true-nature/App_BicycleFinder/README.md

App_BicycleFinder
=================

Bicycle finder in parking area.
It works on TOCOS TWE-Lite.
You can find your bicycle by melody controlled by wireless remote commander.
