true-nature/App_BicycleFinder/Circuits/Receiver/FinderReceiver.kicad_pcb

## KiCad design Circuits/Receiver/FinderReceiver.kicad_pcb (2016-04-13)

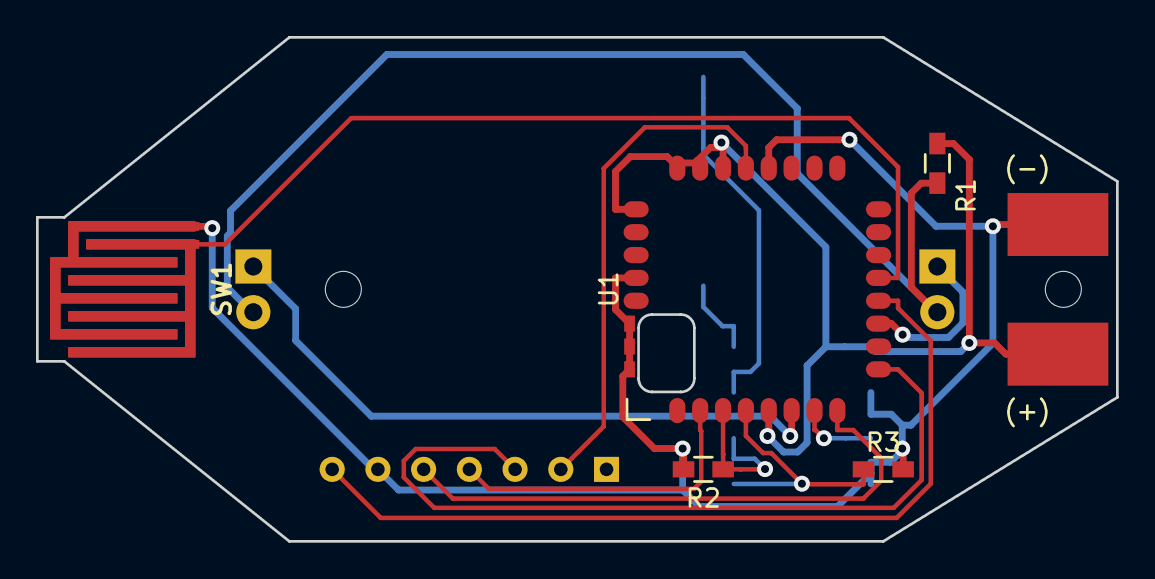
[picture p1: board FinderReceiver.kicad_pcb from above]

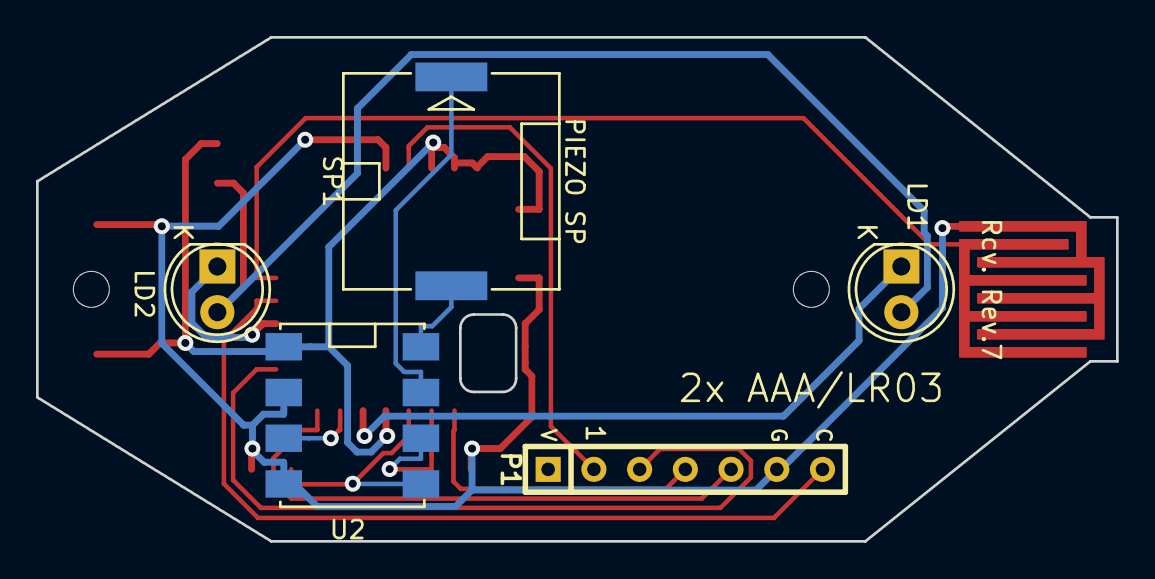
[picture p2: board FinderReceiver.kicad_pcb from below]

Board: 2 copper layers, 60.0 x 28.0 mm, 11 parts (6 on the bottom side), 16 nets.

Parts:
BT1: 2x AAA/LR03; FINDER_RECEIVER
LD1, LD2: LED; LED-5MM
P1: WRITER-VCC; WRITE-7P
R1: 680; R_0603_HandSoldering
R2, R3: 2M; R_0603_HandSoldering
SP1: PIEZO SP; PIEZOSPK
SW1: SW_PUSH; RUBBER_SWITCH
U1: TWE_LITE_SMD; TWE-001L-NC7
U2: NJU72501MJE; AE-NJU72501MJE

Connections:
/CFG: P1.6, U1.12
/DI1: SW1.1, U1.13
/DO3: LD1.1, U1.6
/DO4: LD2.1, U1.11
/EN1: R2.1, U1.3, U2.6
/EN2: R3.1, U1.4, U2.5
/LED: LD1.2, LD2.2, R1.2
/PRG: P1.3, U1.2
/RST: P1.1, U1.21
/RXD: P1.2, U1.9
/SOUND: U1.7, U2.3
/TXD: P1.4, U1.8
/VO1: SP1.1, U2.8
/VO2: SP1.2, U2.7
GND: BT1.2, P1.5, R2.2, R3.2, SW1.2, U1.20, U1.28, U1.30, U1.31, U1.32, U2.2, U2.4
VCC: BT1.1, R1.1, U1.5, U1.22, U1.23, U1.24, U1.25, U2.1
