true-nature/App_BicycleFinder/Circuits/SmallSender/SmallSender.kicad_pcb

## KiCad design Circuits/SmallSender/SmallSender.kicad_pcb (2016-03-06)

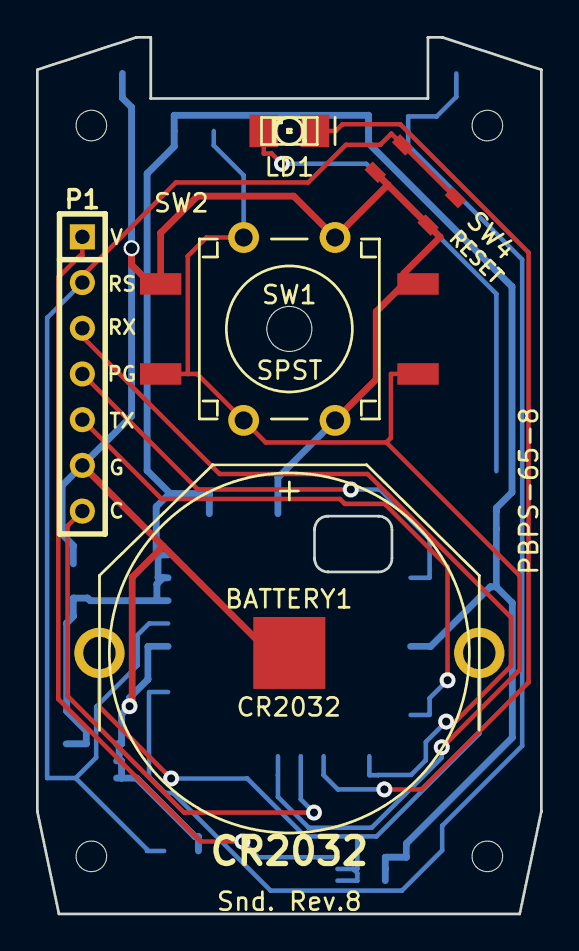
[picture p3: board SmallSender.kicad_pcb from above]

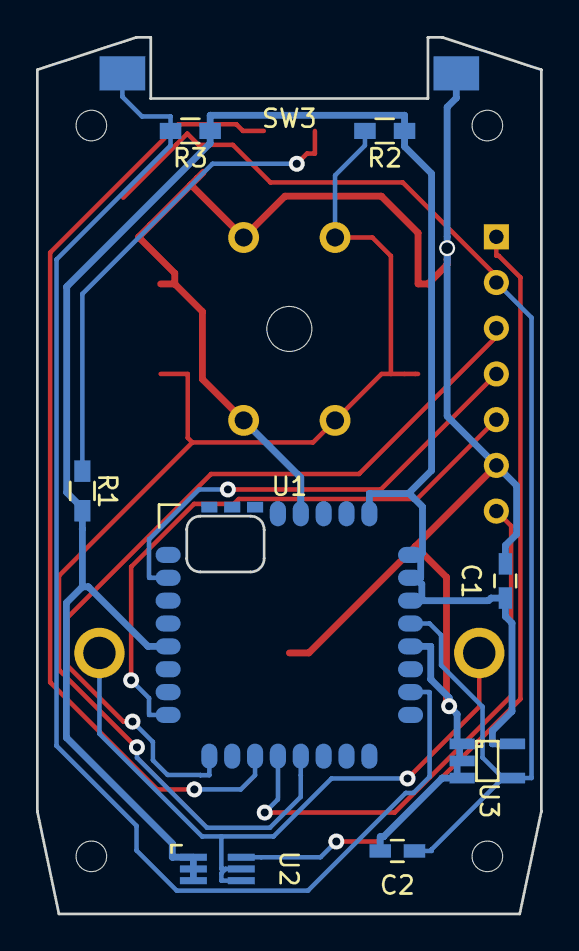
[picture p4: board SmallSender.kicad_pcb from below]

Board: 2 copper layers, 28.0 x 48.7 mm, 16 parts (9 on the bottom side), 13 nets.

Parts:
BATTERY1: CR2032; BK-888
C1: 10u; C_0603_HandSoldering
C2: 1000p; C_0603_HandSoldering
LD1: SML-012WT; LED-1206
P1: WRITER-VCC; WRITE-7P
PBPS-65-8: Snd. Rev.8; PBPS-65
R1: 680; R_0603_HandSoldering
R2, R3: 1M; R_0603_HandSoldering
SW1: SPST; B3FS-4002P_centerHole2_5mm
SW2: SPST; JB-15HFBP2
SW3: FR2S1015
SW4: SKRPACE010
U1: TWE_LITE_SMD; TWE-001L-NC7
U2: HN2S01FU; SC-70-6_Handsoldering
U3: BD45231G; SSOP5_Handsoldering

Connections:
/3V: BATTERY1.1, U2.4, U2.5
/CFG: P1.6, U1.12
/DI1: R2.2, SW1.1, SW2.1, U1.13
/DI4: R3.2, SW3.1, U1.18
/DO4: LD1.1, U1.11
/ExtVcc: P1.0, U2.6
/LED: LD1.2, R1.2
/PRG: P1.3, U1.2
/RST: C2.1, P1.1, SW4.1, U1.21, U3.4
/RXD: P1.2, U1.9
/TXD: P1.4, U1.8
/Vcc: C1.1, R1.1, R2.1, R3.1, U1.5, U1.22, U1.23, U1.24, U1.25, U2.1, U2.2, U2.3, U3.5
GND: BATTERY1.2, C1.2, C2.2, P1.5, SW1.2, SW2.2, SW3.2, SW4.2, U1.20, U1.28, U3.1, U3.2, U3.3
