true-nature/App_BicycleFinder/Common/Source/appsave.h

/****************************************************************************
 * (C) Tokyo Cosmos Electric, Inc. (TOCOS) - all rights reserved.
 *
 * Condition to use: (refer to detailed conditions in Japanese)
 *   - The full or part of source code is limited to use for TWE (TOCOS
 *     Wireless Engine) as compiled and flash programmed.
 *   - The full or part of source code is prohibited to distribute without
 *     permission from TOCOS.
 *
 * 利用条件:
 *   - 本ソースコードは、別途ソースコードライセンス記述が無い限り東京コスモス電機が著作権を
 *     保有しています。
 *   - 本ソースコードは、無保証・無サポートです。本ソースコードや生成物を用いたいかなる損害
 *     についても東京コスモス電機は保証致しません。不具合等の報告は歓迎いたします。
 *   - 本ソースコードは、東京コスモス電機が販売する TWE シリーズ上で実行する前提で公開
 *     しています。他のマイコン等への移植・流用は一部であっても出来ません。
 *
 ****************************************************************************/

#ifndef APPSAVE_H_
#define APPSAVE_H_

#include <jendefs.h>

/** @ingroup FLASH
 * フラッシュ格納データ構造体
 */
typedef struct _tsFlashApp {
	uint32 u32appkey;		//!<
	uint32 u32ver;			//!<

	uint32 u32appid;		//!< アプリケーションID
	uint32 u32chmask;		//!< 使用チャネルマスク（３つまで）
	uint8 u8id;				//!< 論理ＩＤ (子機 1～100まで指定)
	uint8 u8ch;				//!< チャネル（未使用、チャネルマスクに指定したチャネルから選ばれる）
	uint8 u8pow;			//!< 出力パワー (0-3)
	uint8 u8role;			//!< 未使用(将来のための拡張)
	uint8 u8layer;			//!< 未使用(将来のための拡張)

	uint16 u16SleepDur_ms;	//!< mode4 スリープ期間[ms]
	uint16 u16SleepDur_s; 	//!< mode7 スリープ期間[s]
	uint8 u8Fps;			//!< mode3 毎秒送信回数 (4,8,16,32)

	uint32 u32baud_safe;	//!< ボーレート
	uint8 u8parity;         //!< パリティ 0:none, 1:odd, 2:even

	uint32 u32PWM_Hz;		//!< PWM変更設定周期

	uint32 u32Opt;			//!< 色々オプション
	uint32 u32Opt2;		//!< プルアップ設定 bit0:3->DI1-4, bit4-8:DO5-7

	uint8 u8MML_idx;		//!< MML選曲インデックス
} tsFlashApp;


#endif /* APPSAVE_H_ */
