true-nature/App_BicycleFinder/Master/Source/Experimental.h

/****************************************************************************
 * (C) Tokyo Cosmos Electric, Inc. (TOCOS) - 2013 all rights reserved.
 *
 * Condition to use: (refer to detailed conditions in Japanese)
 *   - The full or part of source code is limited to use for TWE (TOCOS
 *     Wireless Engine) as compiled and flash programmed.
 *   - The full or part of source code is prohibited to distribute without
 *     permission from TOCOS.
 *
 * 利用条件:
 *   - 本ソースコードは、別途ソースコードライセンス記述が無い限り東京コスモス電機が著作権を
 *     保有しています。
 *   - 本ソースコードは、無保証・無サポートです。本ソースコードや生成物を用いたいかなる損害
 *     についても東京コスモス電機は保証致しません。不具合等の報告は歓迎いたします。
 *   - 本ソースコードは、東京コスモス電機が販売する TWE シリーズ上で実行する前提で公開
 *     しています。他のマイコン等への移植・流用は一部であっても出来ません。
 *
 ****************************************************************************/

#ifndef EXPERIMENTAL_H_
#define EXPERIMENTAL_H_

/****************************************************************************/
/***        実験的な実装定義                                              ***/
/****************************************************************************/

/** @ingroup MASTER
 * I2C LCD モジュールテスト用のコード
 *   本定義が実装されると、I2C 接続の LCD デバイスにテスト文字を表示する
 *   - IO入力を受け取った時そのボタンに応じたメッセージを表示
 *   - インタラクティブモードで 1-4 に対応してメッセージを表示
 */
#undef USE_I2C_LCD_TEST_CODE
#ifdef USE_I2C_LCD_TEST_CODE
#warning "EXPERIMENTAL: USE_I2C_LCD_TEST_CODE"
const char astrLcdMsgs[4][2][16] = {
	{	"TEST1 67812345678", "ABCDefghIJKLmnop"},
	{	"TEST2 67812345678", "ABCDefghIJKLmnop"},
	{	"TEST3 67812345678", "ABCDefghIJKLmnop"},
	{	"TEST4 67812345678", "ABCDefghIJKLmnop"},
};
#endif

/** @ingroup MASTER
 * Sleep 中に IO の出力状態を設定する
 *   DO0,1を Sleep 中は Hi, 稼働中は Lo
 */
#undef SET_DO_ON_SLEEP
#ifdef SET_DO_ON_SLEEP
#warning "EXPERIMENTAL: SET_DO_ON_SLEEP"
static uint8 u8SleepControl = 0; //!< 0:事前Sleep, 1:通常
#define PRE_SLEEP_ms 50
#endif

/** @ingroup MASTER
 * BROWNOUT 検出時にリセットする。
 */
#undef USE_BROWN_OUT_DETECT
#ifdef USE_BROWN_OUT_DETECT
# warning "#define USE_BROWN_OUT_DETECT"
#endif

/** @ingroup MASTER
 * 電源投入時に一定時間ポートをONにする
 */
#undef USE_INITIAL_PORT_ON //!< 起動時にポートをONにする
#ifdef USE_INITIAL_PORT_ON
# warning "#define USE_INITIAL_PORT_ON"
#endif

/** @ingroup MASTER
 * I2Cポートを入力として利用し、かつチャネル切り替えに使用する
 *
 * 両方のピンが HI の場合は、インタラクティブモードの設定となり、
 * それ以外の場合は、以下に定義している CHMASK_1-3 に切り替わる。
 */
#undef USE_I2C_PORT_AS_CHANNEL_SET
#ifdef USE_I2C_PORT_AS_CHANNEL_SET
#define USE_I2C_PORT_AS_OTHER_FUNCTION
#warning "EXPERIMENTAL: USE_I2C_PORT_AS_CHANNEL_SET"

#define CHANNEL_1 12
#define CHMASK_1 (1UL << CHANNEL_1) //!< チャネルマスク（３つまで指定する事が出来る）
#define CHANNEL_2 21
#define CHMASK_2 (1UL << CHANNEL_2) //!< チャネルマスク（３つまで指定する事が出来る）
#define CHANNEL_3 24
#define CHMASK_3 (1UL << CHANNEL_3) //!< チャネルマスク（３つまで指定する事が出来る）

// チャネルのテーブル
const uint32 au32ChMask_Preset[] = { 0UL, CHMASK_1, CHMASK_2, CHMASK_3, };

// ピンの選択 (0-3)
static uint8 u8ChPreSet = 0;

static void vChangeChannelPreset(uint8 u8preset);
#endif

/** @ingroup MASTER
 * I2Cポートを入力として利用し、かつ PWM の特殊制御に使用する
 * (USE_I2C_PORT_AS_CHANNEL_SET と両方定義すると、チャネル切り替えと
 *  PWM 制御パターンを同時に切り替える)
 *
 * 両ポートがHIの場合は、PWMのデューティ比設定
 * 他の設定は、サイン、脈動、パルス
 *
 * ※ PWM の出力を反転したい場合は、cbToCoNet_u8HwInt() 中の PWM 設定部で
 *    u16duty 値を反転させるとよいだろう。
 *
 *    sTimerPWM[i].u16duty = 1024 - sTimerPWM[i].u16duty; // 値を反転
 *    vTimerStart(&sTimerPWM[i]);
 */
#undef USE_I2C_PORT_AS_PWM_SPECIAL

#if defined(USE_I2C_PORT_AS_PWM_SPECIAL)
#define USE_I2C_PORT_AS_OTHER_FUNCTION
#warning "EXPERIMENTAL: USE_I2C_PORT_AS_OTHER_FUNCTION"
uint8 u8PwmSpe_TxMode = 0;
uint8 u8PwmSpe_RxMode = 0;

// タイマー管理のためのカウンター
struct {
	uint16 u16Ct_Active[4]; // Active 期間のカウンタ数 (このときだけ光る）
	uint16 u16Ct_Total[4]; // トータルカウンタ数
	uint16 u16Ct_Now[4]; // 現在のカウント値 (100でループする)
} sPwmSpe_Context;

// サイン波のテーブル
const uint16 u16PwmSpe_SinTbl[101] = { 0, 32, 64, 96, 128, 160, 192, 223, 255,
		286, 316, 347, 377, 407, 436, 465, 493, 521, 549, 576, 602, 628, 653,
		677, 701, 724, 746, 768, 789, 809, 828, 847, 865, 881, 897, 912, 927,
		940, 952, 963, 974, 983, 992, 999, 1006, 1011, 1016, 1019, 1022, 1023,
		1024, 1023, 1022, 1019, 1016, 1011, 1006, 999, 992, 983, 974, 963, 952,
		940, 927, 912, 897, 881, 865, 847, 828, 809, 789, 768, 746, 724, 701,
		677, 653, 628, 602, 576, 549, 521, 493, 465, 436, 407, 377, 347, 316,
		286, 255, 223, 192, 160, 128, 96, 64, 32, 0 };

// ふわっとするテーブル
const uint16 u16PwmSpe_fuwa[101] = { 0, 0, 2, 4, 7, 10, 15, 20, 26, 33, 41, 50,
		59, 69, 80, 92, 105, 118, 133, 148, 164, 181, 198, 217, 236, 256, 277,
		299, 321, 344, 369, 394, 419, 446, 473, 502, 531, 561, 591, 623, 655,
		689, 723, 757, 793, 829, 867, 905, 944, 983, 1024, 1024, 1024, 1024,
		1024, 1024, 1024, 1024, 1024, 1024, 960, 896, 832, 768, 704, 640, 576,
		512, 448, 384, 320, 256, 192, 128, 64, 0, 0, 0, 0, 0, 0, 0, 0, 0, 0, 0,
		0, 0, 0, 0, 0, 0, 0, 0, 0, 0, 0, 0, 0, 0, 0 };

// 可変抵抗の C カーブから B カーブへの変換（意味あるかな？）
const uint16 au16_CtoBcurve[1025] = { 0, 4, 8, 12, 16, 20, 24, 28, 32, 36, 40,
		44, 47, 51, 55, 58, 62, 66, 69, 73, 76, 80, 83, 87, 90, 93, 97, 100,
		103, 106, 110, 113, 116, 119, 122, 126, 129, 132, 135, 138, 141, 144,
		147, 150, 153, 156, 158, 161, 164, 167, 170, 173, 175, 178, 181, 184,
		186, 189, 192, 194, 197, 200, 202, 205, 207, 210, 212, 215, 217, 220,
		222, 225, 227, 230, 232, 235, 237, 239, 242, 244, 247, 249, 251, 254,
		256, 258, 260, 263, 265, 267, 269, 272, 274, 276, 278, 280, 282, 285,
		287, 289, 291, 293, 295, 297, 299, 301, 303, 305, 308, 310, 312, 314,
		316, 318, 320, 321, 323, 325, 327, 329, 331, 333, 335, 337, 339, 341,
		343, 344, 346, 348, 350, 352, 354, 355, 357, 359, 361, 363, 364, 366,
		368, 370, 371, 373, 375, 377, 378, 380, 382, 384, 385, 387, 389, 390,
		392, 394, 395, 397, 399, 400, 402, 403, 405, 407, 408, 410, 411, 413,
		415, 416, 418, 419, 421, 422, 424, 426, 427, 429, 430, 432, 433, 435,
		436, 438, 439, 441, 442, 444, 445, 447, 448, 450, 451, 452, 454, 455,
		457, 458, 460, 461, 462, 464, 465, 467, 468, 469, 471, 472, 474, 475,
		476, 478, 479, 480, 482, 483, 484, 486, 487, 488, 490, 491, 492, 494,
		495, 496, 498, 499, 500, 502, 503, 504, 505, 507, 508, 509, 510, 512,
		513, 514, 515, 517, 518, 519, 520, 522, 523, 524, 525, 527, 528, 529,
		530, 531, 533, 534, 535, 536, 537, 539, 540, 541, 542, 543, 544, 546,
		547, 548, 549, 550, 551, 552, 554, 555, 556, 557, 558, 559, 560, 562,
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
		365, 366, 367, 368, 369, 370, 371, 372, 373, 374, 375, 376, 377, 378,
		379, 380, 381, 382, 383, 384, 385, 386, 387, 388, 389, 390, 391, 392,
		393, 394, 395, 396, 397, 398, 399, 400, 401, 402, 404, 405, 406, 407,
		408, 409, 410, 411, 412, 413, 414, 415, 416, 417, 418, 419, 420, 422,
		423, 424, 425, 426, 427, 428, 429, 430, 431, 432, 433, 435, 436, 437,
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

#endif

/** @ingroup MASTER
 * AI4 の変わりに電源電圧を読み出して送信する。
 *
 * 2.5V 以上 (PWM=0%) 2.5V 以下 (PWM=50%), 2.3V以下 (PWM=100%)
 */
#undef USE_PWM4_AS_BAT_MONITOR
#ifdef USE_PWM4_AS_BAT_MONITOR
#warning "EXPERIMENTAL: USE_PWM4_AS_BAT_MONITOR"
#endif

/** @ingroup MASTER
 * 間欠モード時にゆっくり送信する
 */
#undef USE_SLOW_TX
#ifdef USE_SLOW_TX
#warning "EXPERIMENTAL: USE_SLOW_TX"
#endif
#endif /* EXPERIMENTAL_H_ */
