true-nature/App_BicycleFinder/(commit log)

2014-09-09 App_TweLite 1.7から派生。
2014-09-10 スリープ抑止を開放するため、再生終了時にbHoldPlayをFALSEに変える。
2014-09-10 シリアル番号をベースにした独自のAPP_IDへ変更。
2014-09-10 1秒スリープでの受信処理を有効化。 メロディ再生中はスリープを抑止。
2014-09-10 改造部分を ENABLE_RX_ON_SLP_1SEC で切り分けた。
2014-09-10 リリースノートを独自内容に変更。
2014-09-10 再生の終了待ちを独立した状態に分離。
2014-09-10 再生待ちを行うユーザー定義状態を新設。 再生の最大時間を60秒に制限。
2014-09-13 3曲目のメロディをHappy Birthdayに変更。
2014-09-13 間欠受信に失敗。
2014-09-13 他のdefineにあわせてUSE_RX_ON_SLP_1SECにrename。
2014-09-13 誤って除隊したSILENT_MODEの受信処理スキップを元に戻した。
2014-09-13 Revert "誤って除隊したSILENT_MODEの受信処理スキップを元に戻した。"
    This reverts commit 6c30a227d46dbb01fb6ffa2821d9764f91923357.
    [Master.c]
2014-09-13 SILENT_MODEと誤認して戻した変更を戻した。
2014-09-14 再生中で無い場合にLEDが一瞬点滅する場合があるバグを修正。
2014-09-14 バッテリー電圧が低下したときに点滅周期を短くする機能を追加。
2014-09-16 連続モードでもLEDを点滅させるようにした。
2014-09-17 状態遷移のタイミングをUARTに出力
2014-09-18 ADC無効化オプションが指定された場合、電源電圧だけをADC対象とする。 子機間欠モードでADC実行間隔を延長できるようにした。
2014-09-18 ADCスキップ時に受信時間を確保する。
2014-09-18 受信待ちを独立した状態で確保。
2014-09-18 連続送信を毎秒64回に増やしてWakeUp時間を減らした。
2014-09-22 再生終了時は無条件に割り込み時の再生処理を無効とする。
2014-09-22 リモコン側を子機間欠10秒モードで使用。
2014-09-23 mode4の通信間隔デフォルト値を4秒に延長。
2014-09-23 改造結果をリリースノートに反映。
2014-09-23 Bsch3vで描いた回路図を追加。
2014-09-24 SMD(QFN)版回路図を追加。
2014-09-24 QFN版DO4,GND配線ミスを修正。
2014-09-24 RESET SWを記入。
2014-09-25 未使用の宣言を削除。
2014-09-25 誤ったstatic修飾を削除。
2014-10-01 Moved circuit diagram to subdirectory.
2014-10-14 子機から子機への通信を、宛先IDによって有効とする。
2014-12-15 Change operation mode to 3,4 or 7 by Device Id.
2014-12-15 Removed pull-up of analog input. Added program writer connector.
2014-12-15 Added SMD version of sender circuit.
2014-12-16 コマンド0x95,0x96でMMLデータのread/writeを定義。
2014-12-18 Reduced wires.
2014-12-18 Fixed: EEPROM were overwritten.
    [melody_defs.c]
2014-12-19 Created KiCAD project file.
    [BicycleFinder.sch]
2014-12-19 User more LEDs.
2014-12-20 Inverted octave up/down characters.
    [melody_defs.c, mml.c]
2014-12-20 Blink LED3, like LED4.
2014-12-20 子機間欠モードでチャンネル指定が有効になるようにした。
2014-12-22 Fixed: MML data was shorten before save.
    [melody_defs.c]
2014-12-22 Continuous transmission is allowed if battery level is sufficient.
2014-12-22 Replaced voltage values to macro.
    [Master.c]
2014-12-22 bWakeupByButton is not reliable. Determine to repeat or not by EDLC voltage.
2014-12-24 Updated KiCAD data.
    [BicycleFinder.sch]
2014-12-25 ERC passed.
    [BicycleFinder.kicad_pcb, BicycleFinder.sch]
2014-12-25 Added parentheses. Static analysis says that it may be a bug.
    [Master.c]
2014-12-30 Made an example layout.
    [BicycleFinder.kicad_pcb, BicycleFinder.sch]
2015-01-04 CS75サイズ検討中。
    [BicycleFinder.kicad_pcb]
2015-01-06 Inserted a register to reduce discharge current from CR2032.
2015-01-07 Trying layout on TAKACHI PS-85.
    [BicycleFinder.kicad_pcb, BicycleFinder.sch]
2015-01-07 Removed old route.
    [BicycleFinder.kicad_pcb]
2015-01-07 Added monitor LED.
    [BicycleFinder.kicad_pcb, BicycleFinder.sch]
2015-01-08 Moved PS-85 shape to Edge layer.
    [BicycleFinder.kicad_pcb]
2015-01-08 Added an antenna shape in F.Silk layer.
    [BicycleFinder.kicad_pcb, BicycleFinder.sch]
2015-01-08 Added 3D data of 1F EDLC designed by FreeCAD.
    [SE-5R5-D105VY.FCStd]
2015-01-09 Created a 3D shape of EDLC.
    [BicycleFinder.kicad_pcb]
2015-01-09 Added FreeCAD 3D model of TWE-001L-SMD.
    [TWE-001L-SMD.FCStd]
2015-01-09 Add 3D data of TWE-001L-SMD to KiCAD module.
    [BicycleFinder.kicad_pcb, TWE-001L-SMD.FCStd]
2015-01-10 Updated 3D model of 1F EDLC.
    [BicycleFinder.kicad_pcb, SE-5R5-D105VY.FCStd]
2015-01-10 Added 3D model of tactical switch.
    [BicycleFinder.kicad_pcb, JF-15CKCBNP2.FCStd]
2015-01-11 Colored 1F EDLC.
    [BicycleFinder.kicad_pcb, BicycleFinder.sch, SE-5R5-D105VY.FCStd, TWE-001L-SMD.FCStd]
2015-01-12 Added 3D model of BK-888, BK-2032M, CR2032.
    [BicycleFinder.kicad_pcb]
2015-01-12 Marked plus sign on BK-888 3D model.
    [BK-888.FCStd, BicycleFinder.kicad_pcb]
2015-01-12 Swapped location of bigger parts.
    [BicycleFinder.kicad_pcb, JF-15CKCBNP2.FCStd]
2015-01-12 Moved P1 to keep distance from NTH.
    [BicycleFinder.kicad_pcb]
2015-01-14 Fixed: Miss-connected GND line.
    [BicycleFinder.kicad_pcb, BicycleFinder.sch]
2015-01-14 Don't use arc in Edge.Cut layer.
    [BicycleFinder.kicad_pcb]
2015-01-14 Added a diode array.
    [BicycleFinder.kicad_pcb, BicycleFinder.sch, HN2S01FU.FCStd]
2015-01-16 Replaced BK-888 to SMTU2032.
    [BK-888.FCStd, BicycleFinder.kicad_pcb, BicycleFinder.sch, SMTU2032.FCStd]
2015-01-16 Added 3D model of PS-85.
    [PS-85.FCStd]
2015-01-18 Replaced EDLC. Moved origin of TWE-001L.
    [BicycleFinder.kicad_pcb, BicycleFinder.sch, SE-5R5-D105VYV.FCStd, TWE-001L-SMD.FCStd]
2015-01-18 Added indicator LED.
2015-01-20 Copied models from DoorChecker.
    [BicycleFinder.kicad_pcb, BicycleFinder.sch]
2015-01-21 Moved BSch3V data to subdirectory.
    [BK-888.FCStd, BicycleFinder.kicad_pcb, BicycleFinder.sch, HN2S01FU.FCStd, JF-15CKCBNP2.FCStd, PS-85.FCStd, SE-5R5-D105VY.FCStd, SE-5R5-D105VYV.FCStd]
2015-01-21 Moved libraries to ../kicad-twe.
    [BK-888.FCStd, HN2S01FU.FCStd, JF-15CKCBNP2.FCStd, PS-85.FCStd, SE-5R5-D105VY.FCStd, SE-5R5-D105VYV.FCStd, SMTU2032.FCStd, TWE-001L-SMD.FCStd]
2015-01-29 Reviewed parts layout.
    [BicycleFinder.kicad_pcb, BicycleFinder.sch]
2015-01-30 Changed current restriction register value.
    [BicycleFinder.sch]
2015-01-30 Moved some chip parts.
    [BicycleFinder.kicad_pcb]
2015-01-31 Moved pin names of writer to F.Silk layer.
    [BicycleFinder.kicad_pcb]
2015-02-06 Moved location of 3D models.
    [BicycleFinder.kicad_pcb]
2015-02-08 発信前にチャタリング防止。空振り対策のため1/64秒毎に発信。
2015-02-15 Started to design the receiver.
    [FinderReceiver.kicad_pcb, FinderReceiver.sch]
2015-02-17 Locate the TWE-Lite SMD on the front side.
    [FinderReceiver.kicad_pcb, FinderReceiver.sch]
2015-02-17 Added spare footprints.
    [FinderReceiver.kicad_pcb, FinderReceiver.sch]
2015-02-18 Fixed: LED location.
    [FinderReceiver.kicad_pcb, FinderReceiver.sch]
2015-02-18 Added sender with a reed switch.
    [SmallSender.sch]
2015-02-18 Started to design a PCB.
    [SmallSender.kicad_pcb, SmallSender.sch]
2015-02-20 Replaced EDLC.
    [BicycleFinder.kicad_pcb, BicycleFinder.sch, SmallSender.kicad_pcb, SmallSender.sch]
2015-02-20 Added a 3D model of PS-65.
    [SmallSender.kicad_pcb]
2015-02-21 Changed battery holder. Added more EDLC.
    [SmallSender.kicad_pcb, SmallSender.sch]
2015-02-22 Changed EDLC.
    [FinderReceiver.kicad_pcb, SmallSender.kicad_pcb, SmallSender.sch]
2015-02-22 Pullup all analog inputs.
    [FinderReceiver.sch]
2015-02-23 Reload net list.
    [FinderReceiver.kicad_pcb]
2015-02-24 Modified some connections.
    [FinderReceiver.kicad_pcb, SmallSender.kicad_pcb]
2015-02-24 Fixed: Sound output is connected to PWM1.
    [FinderReceiver.kicad_pcb, FinderReceiver.sch]
2015-02-24 Fixed: Model with NPH hole.
    [SmallSender.kicad_pcb]
2015-02-26 Reviewing connections.
    [BicycleFinder.kicad_pcb, BicycleFinder.sch]
2015-02-28 Sleep immediately after brownout reset.
    [Master.c]
2015-03-01 Updated connections.
    [BicycleFinder.kicad_pcb, BicycleFinder.sch]
2015-03-01 Disabled brown out detection.
    [Master.c]
2015-03-01 Added reset monitor.
    [SmallSender.sch]
2015-03-02 Added voltage monitor.
    [SmallSender.kicad_pcb, SmallSender.sch]
2015-03-02 Replaced TWE-Lite module.
    [SmallSender.kicad_pcb]
2015-03-03 Disable reset monitor after boot.
    [Master.c, config.h]
2015-03-04 Relocated the reset monitor.
    [SmallSender.kicad_pcb, SmallSender.sch]
2015-03-05 Removed an unused connection.
    [SmallSender.sch]
2015-03-09 Omit external pull-up registers.
    [SmallSender.kicad_pcb, SmallSender.sch]
2015-03-10 Replaced tactical switch to SMD type.
    [SmallSender.kicad_pcb, SmallSender.sch]
2015-03-11 Use fixed dst id.
    [Master.c, Slave.c, config.h]
2015-03-16 Start to edit by KiCad nightly build.
    [SmallSender.sch]
2015-03-16 Replaced to current footprint modules.
    [SmallSender.sch]
2015-03-21 Switch GND by a voltage detector.
    [FinderReceiver.kicad_pcb, SmallSender.kicad_pcb, SmallSender.sch]
2015-03-21 Skip to restore DO1 status.
    [Master.c]
2015-03-22 Moved LED to front side.
    [SmallSender.kicad_pcb, SmallSender.sch]
2015-03-22 Blink secondary LED connected to DO3.
2015-03-22 Removed piezo speaker on front side.
    [FinderReceiver.kicad_pcb, FinderReceiver.sch]
2015-03-22 Added library table.
    [FinderReceiver.sch]
2015-03-22 Removed old big sender.
    [BicycleFinder.kicad_pcb, BicycleFinder.sch]
2015-03-29 Changed library file name from TWE-Lite to favorites. Added NJU72501MJE piezo speaker driver.
    [FinderReceiver.kicad_pcb, FinderReceiver.sch]
2015-03-29 Control EN2 by DO2 GPIO instead of a jumper.
    [FinderReceiver.kicad_pcb, FinderReceiver.sch]
2015-03-29 Relocated module path.
    [SmallSender.kicad_pcb, SmallSender.sch]
2015-03-30 Fast blink only if battery voltage itself is low.
2015-04-12 Updated 3d models.o
    [SmallSender.kicad_pcb]
2015-04-19 Added NJU72501 charge pump module.
2015-04-19 Run PWM timer while playing MML only.
2015-04-20 Added reset switch to sender.
    [SmallSender.sch]
2015-04-21 Added SMD tactical switch.
    [SmallSender.kicad_pcb]
2015-04-21 Fixed: Obsoleted battery symbol.
    [SmallSender.kicad_pcb, SmallSender.sch]
2015-04-25 Added RESET rubber switch.
    [FinderReceiver.kicad_pcb, FinderReceiver.sch]
2015-04-26 Replaced footprint of SMD register.
    [FinderReceiver.kicad_pcb]
2015-05-06 Fixed 3D footprint path.
    [SmallSender.kicad_pcb]
2015-06-08 Changed LED symbol and register value.
    [SmallSender.sch]
2015-06-08 Removed reset switch and connected SW1 to DI1.
    [FinderReceiver.sch]
2015-06-09 Relocated all parts.
    [FinderReceiver.kicad_pcb, FinderReceiver.sch]
2015-06-09 Relocated base PCB.
    [FinderReceiver.kicad_pcb, FinderReceiver.sch]
2015-06-09 Artwork in progress.
    [FinderReceiver.kicad_pcb]
2015-06-10 Shrunk rubber switch pattern.
    [FinderReceiver.kicad_pcb]
2015-06-10 Changed location of parts.
    [FinderReceiver.kicad_pcb]
2015-06-14 Replaced outline edge.
    [FinderReceiver.kicad_pcb]
2015-06-14 Fixed operation mode. Switch config mode by PORT_CONF1.
    [Slave.c, appdata.h]
2015-06-14 Fixed operation mode of master side. Switch config mode by PORT_CONF1.
    [Master.c, Slave.c, appdata.h, common.h]
2015-06-14 Implementing LED flasher mode.
2015-06-15 ToDoコメントを追加。
2015-06-17 Connect DO1 to EN1.
    [FinderReceiver.kicad_pcb, FinderReceiver.sch]
2015-06-18 Added pull down registers.
    [FinderReceiver.kicad_pcb, FinderReceiver.sch]
2015-06-20 Changed size of pad holes.
    [FinderReceiver.kicad_pcb]
2015-06-28 Worked LED flasher mode.
2015-06-28 Changed flasher led pattern.
2015-06-30 Replaced the reset IC.
    [SmallSender.kicad_pcb, SmallSender.sch]
2015-07-01 Replaced reset IC.
    [SmallSender.kicad_pcb, SmallSender.sch]
2015-07-01 Added pull-down register and buffer capacitor.
    [SmallSender.kicad_pcb, SmallSender.sch]
2015-07-02 Relocated some parts.
    [FinderReceiver.kicad_pcb]
2015-07-03 Hide footprint names.
    [SmallSender.sch]
2015-07-03 Changed register value.
    [SmallSender.sch]
2015-07-04 Updated footprints.
    [FinderReceiver.kicad_pcb, FinderReceiver.sch, SmallSender.kicad_pcb, SmallSender.sch]
2015-07-07 Added dual SPST dip switch.
    [FinderReceiver.kicad_pcb, FinderReceiver.sch]
2015-07-12 Fixed: Kathode mark was opposite.
    [SmallSender.kicad_pcb]
2015-07-12 Initialize PWM sate low.
2015-07-19 Swap TWE-Lite and PIEZO Speaker.
    [FinderReceiver.kicad_pcb]
2015-07-25 Fixed: A slave responses IO packet from other slaves.
    [Master.c, Slave.c, common.h]
2015-07-25 Changed text in silk.
    [SmallSender.kicad_pcb]
2015-08-09 Changed battery threshold.
2015-08-16 Continue if battery level is low.
2015-08-16 Use CR2032 instead of CR1220.
    [SmallSender.kicad_pcb, SmallSender.sch]
2015-10-12 Save current layout.
    [FinderReceiver.kicad_pcb]
2015-12-06 Connect SW3 to M2.
    [SmallSender.kicad_pcb, SmallSender.sch]
2015-12-07 Changed location of a tactical switch.
    [SmallSender.kicad_pcb]
2015-12-13 Added drill center hole.
    [SmallSender.kicad_pcb]
2016-01-06 Duplicated trigger tactical switch.
    [SmallSender.kicad_pcb, SmallSender.sch]
2016-02-11 Blink LED while auto pairing.
2016-02-18 Added voltage detector.
    [SmallSender.kicad_pcb, SmallSender.sch]
2016-02-26 Added a voltage detector.
    [SmallSender.kicad_pcb, SmallSender.sch]
2016-02-26 Added 3D shape of a SMD LED.
    [SmallSender.kicad_pcb, SmallSender.sch]
2016-02-26 Moved location of LED reference.
    [SmallSender.kicad_pcb]
2016-02-28 Added external pull-up register.
    [SmallSender.kicad_pcb, SmallSender.sch]
2016-02-29 Renamed the folder name of 3d shapes.
    [SmallSender.kicad_pcb]
2016-03-03 Down the battery alert level.
2016-03-06 Connect SW4 to RESET instead of M2.
    [SmallSender.kicad_pcb, SmallSender.sch]
2016-04-07 Changed directory name of 3D shapes.
    [FinderReceiver.kicad_pcb]
2016-04-13 Added silent melody. Removed volume switch(SW2) from receiver.
    [FinderReceiver.kicad_pcb, FinderReceiver.sch]
2016-06-21 経過時間の判定をE_EVENT_TICK_TIMERで行う。
2016-06-26 Defined ADC state constants.
2017-01-22 不感時間を設けてチャタリングの影響を回避。
2017-01-22 KiCadとEclipsewをアップデート。
    [FinderReceiver.sch, SmallSender.sch]
